choiyeoji/bremen-fpga-vision-orchestra/images/tb.png

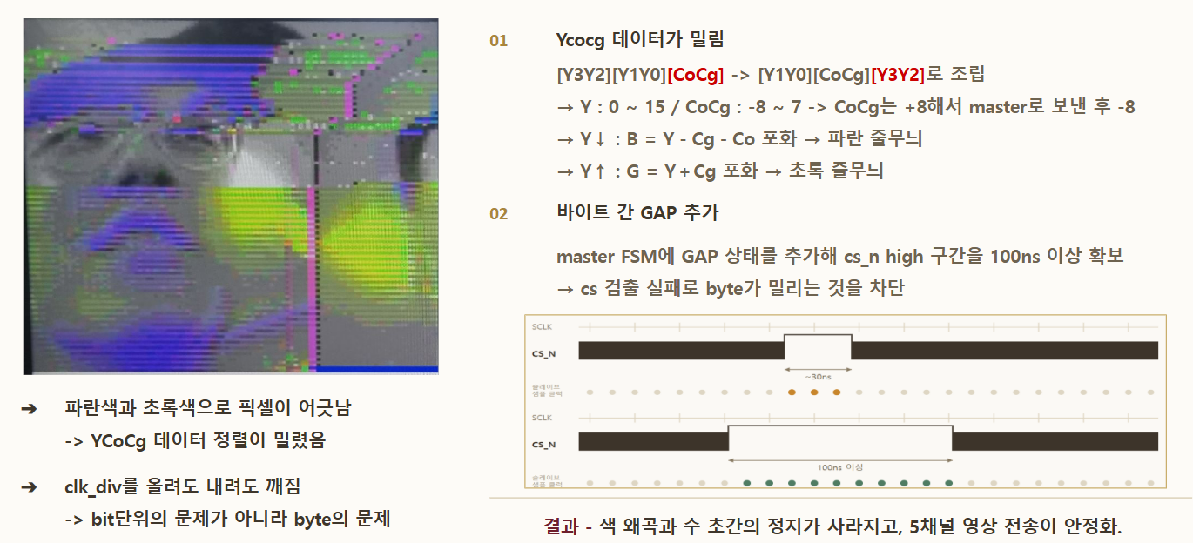
images/tb.png
