choiyeoji/bremen-fpga-vision-orchestra/images/uvm_bd.png

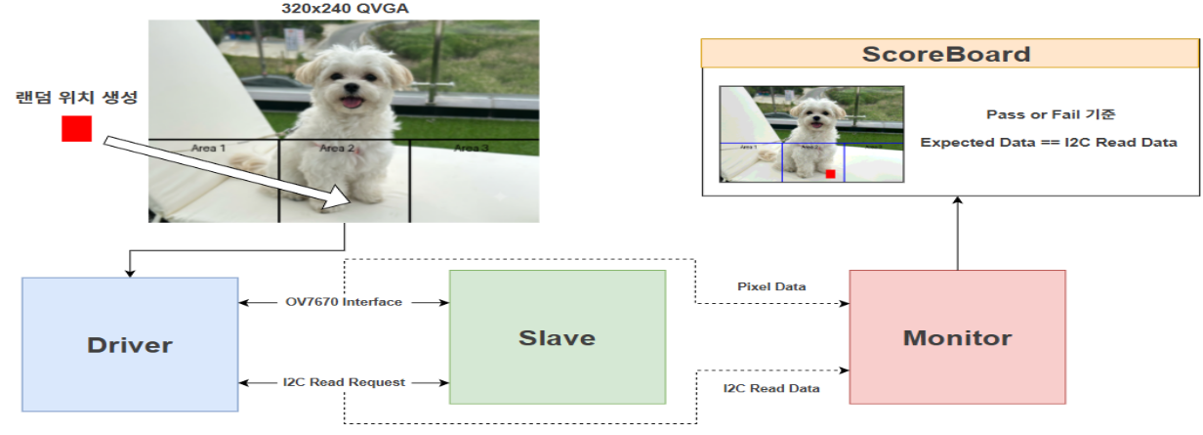
images/uvm_bd.png
