choiyeoji/bremen-fpga-vision-orchestra/images/uvm_report.png

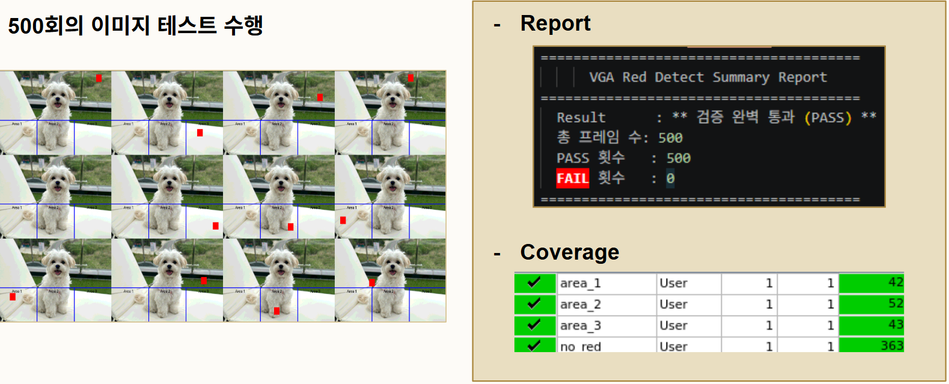
images/uvm_report.png
