choiyeoji/bremen-fpga-vision-orchestra/src/master/constraints/Basys-3-Master.xdc

## This file is a general .xdc for the Basys3 rev B board
## To use it in a project:
## - uncomment the lines corresponding to used pins
## - rename the used ports (in each line, after get_ports) according to the top level signal names in the project
# Clock signal
set_property -dict { PACKAGE_PIN W5   IOSTANDARD LVCMOS33 } [get_ports clk]
create_clock -add -name sys_clk_pin -period 10.00 -waveform {0 5} [get_ports clk]


# ## Switches
# set_property -dict { PACKAGE_PIN V17   IOSTANDARD LVCMOS33 } [get_ports {led[0]}]
# set_property -dict { PACKAGE_PIN V16   IOSTANDARD LVCMOS33 } [get_ports {led[1]}]
# set_property -dict { PACKAGE_PIN W16   IOSTANDARD LVCMOS33 } [get_ports {sw_mode[1]}]
# set_property -dict { PACKAGE_PIN W17   IOSTANDARD LVCMOS33 } [get_ports {sw_clr_red}]
# set_property -dict { PACKAGE_PIN W15   IOSTANDARD LVCMOS33 } [get_ports {sw_clr_green}]
# set_property -dict { PACKAGE_PIN V15   IOSTANDARD LVCMOS33 } [get_ports {sw_clr_blue}]
# set_property -dict { PACKAGE_PIN W14   IOSTANDARD LVCMOS33 } [get_ports {sw_green[2]}]
# set_property -dict { PACKAGE_PIN W13   IOSTANDARD LVCMOS33 } [get_ports {sw_green[3]}]
# set_property -dict { PACKAGE_PIN V2    IOSTANDARD LVCMOS33 } [get_ports {sw_blue[0]}]
# set_property -dict { PACKAGE_PIN T3    IOSTANDARD LVCMOS33 } [get_ports {sw_blue[1]}]
# set_property -dict { PACKAGE_PIN T2    IOSTANDARD LVCMOS33 } [get_ports {sw_blue[2]}]
# set_property -dict { PACKAGE_PIN R3    IOSTANDARD LVCMOS33 } [get_ports {sw_blue[3]}]
# set_property -dict { PACKAGE_PIN W2    IOSTANDARD LVCMOS33 } [get_ports {sw[12]}]
# set_property -dict { PACKAGE_PIN U1    IOSTANDARD LVCMOS33 } [get_ports {sw[13]}]
# set_property -dict { PACKAGE_PIN T1    IOSTANDARD LVCMOS33 } [get_ports {sw_mode}]
# set_property -dict { PACKAGE_PIN R2    IOSTANDARD LVCMOS33 } [get_ports {sw_mode[1]}]


## LEDs
set_property -dict { PACKAGE_PIN U16   IOSTANDARD LVCMOS33 } [get_ports {led[0]}]
set_property -dict { PACKAGE_PIN E19   IOSTANDARD LVCMOS33 } [get_ports {led[1]}]
set_property -dict { PACKAGE_PIN U19   IOSTANDARD LVCMOS33 } [get_ports {led[2]}]
set_property -dict { PACKAGE_PIN V19   IOSTANDARD LVCMOS33 } [get_ports {led[3]}]
set_property -dict { PACKAGE_PIN W18   IOSTANDARD LVCMOS33 } [get_ports {led[4]}]
set_property -dict { PACKAGE_PIN U15   IOSTANDARD LVCMOS33 } [get_ports {led[5]}]
set_property -dict { PACKAGE_PIN U14   IOSTANDARD LVCMOS33 } [get_ports {led[6]}]
set_property -dict { PACKAGE_PIN V14   IOSTANDARD LVCMOS33 } [get_ports {led[7]}]
#set_property -dict { PACKAGE_PIN V13   IOSTANDARD LVCMOS33 } [get_ports {led[8]}]
#set_property -dict { PACKAGE_PIN V3    IOSTANDARD LVCMOS33 } [get_ports {led[9]}]
#set_property -dict { PACKAGE_PIN W3    IOSTANDARD LVCMOS33 } [get_ports {led[10]}]
#set_property -dict { PACKAGE_PIN U3    IOSTANDARD LVCMOS33 } [get_ports {led[11]}]
#set_property -dict { PACKAGE_PIN P3    IOSTANDARD LVCMOS33 } [get_ports {led[12]}]
#set_property -dict { PACKAGE_PIN N3    IOSTANDARD LVCMOS33 } [get_ports {led[13]}]
#set_property -dict { PACKAGE_PIN P1    IOSTANDARD LVCMOS33 } [get_ports {led[14]}]
#set_property -dict { PACKAGE_PIN L1    IOSTANDARD LVCMOS33 } [get_ports {led[15]}]


##7 Segment Display
# set_property -dict { PACKAGE_PIN W7   IOSTANDARD LVCMOS33 } [get_ports {fnd_data[0]}]
# set_property -dict { PACKAGE_PIN W6   IOSTANDARD LVCMOS33 } [get_ports {fnd_data[1]}]
# set_property -dict { PACKAGE_PIN U8   IOSTANDARD LVCMOS33 } [get_ports {fnd_data[2]}]
# set_property -dict { PACKAGE_PIN V8   IOSTANDARD LVCMOS33 } [get_ports {fnd_data[3]}]
# set_property -dict { PACKAGE_PIN U5   IOSTANDARD LVCMOS33 } [get_ports {fnd_data[4]}]
# set_property -dict { PACKAGE_PIN V5   IOSTANDARD LVCMOS33 } [get_ports {fnd_data[5]}]
# set_property -dict { PACKAGE_PIN U7   IOSTANDARD LVCMOS33 } [get_ports {fnd_data[6]}]
# set_property -dict { PACKAGE_PIN V7   IOSTANDARD LVCMOS33 } [get_ports {fnd_data[7]}]

# set_property -dict { PACKAGE_PIN U2   IOSTANDARD LVCMOS33 } [get_ports {fnd_digit[0]}]
# set_property -dict { PACKAGE_PIN U4   IOSTANDARD LVCMOS33 } [get_ports {fnd_digit[1]}]
# set_property -dict { PACKAGE_PIN V4   IOSTANDARD LVCMOS33 } [get_ports {fnd_digit[2]}]
# set_property -dict { PACKAGE_PIN W4   IOSTANDARD LVCMOS33 } [get_ports {fnd_digit[3]}]


##Buttons
set_property -dict { PACKAGE_PIN U18   IOSTANDARD LVCMOS33 } [get_ports reset]
# set_property -dict { PACKAGE_PIN T18   IOSTANDARD LVCMOS33 } [get_ports OV_init_btn]
# set_property -dict { PACKAGE_PIN W19   IOSTANDARD LVCMOS33 } [get_ports btn_l]
# set_property -dict { PACKAGE_PIN T17   IOSTANDARD LVCMOS33 } [get_ports btn_r]
# set_property -dict { PACKAGE_PIN U17   IOSTANDARD LVCMOS33 } [get_ports btn_down]


##Pmod Header JA
set_property -dict { PACKAGE_PIN J1   IOSTANDARD LVCMOS33 } [get_ports {sclk}];#Sch name = JA1
# set_property -dict { PACKAGE_PIN L2   IOSTANDARD LVCMOS33 } [get_ports {miso[0]}];#Sch name = JA2
set_property -dict { PACKAGE_PIN J2   IOSTANDARD LVCMOS33 } [get_ports {mosi}];#Sch name = JA3
set_property -dict { PACKAGE_PIN G2   IOSTANDARD LVCMOS33 } [get_ports {cs_n[0]}];#Sch name = JA4
set_property -dict { PACKAGE_PIN H1   IOSTANDARD LVCMOS33 } [get_ports {cs_n[1]}];#Sch name = JA7
set_property -dict { PACKAGE_PIN K2   IOSTANDARD LVCMOS33 } [get_ports {cs_n[2]}];#Sch name = JA8
set_property -dict { PACKAGE_PIN H2   IOSTANDARD LVCMOS33 } [get_ports {cs_n[3]}];#Sch name = JA9
set_property -dict { PACKAGE_PIN G3   IOSTANDARD LVCMOS33 } [get_ports {cs_n[4]}];#Sch name = JA10

##Pmod Header JB
# set_property CLOCK_DEDICATED_ROUTE FALSE [get_nets pclk_IBUF]
set_property -dict { PACKAGE_PIN A14   IOSTANDARD LVCMOS33 } [get_ports {scl}];#Sch name = JB1
set_property -dict { PACKAGE_PIN A16   IOSTANDARD LVCMOS33 } [get_ports {vsync}];#Sch name = JB2
set_property -dict { PACKAGE_PIN B15   IOSTANDARD LVCMOS33 } [get_ports {sda}];#Sch name = JB3
# set_property -dict { PACKAGE_PIN B16   IOSTANDARD LVCMOS33 } [get_ports {sda}];#Sch name = JB4
# set_property -dict { PACKAGE_PIN A15   IOSTANDARD LVCMOS33 } [get_ports {href}];#Sch name = JB7
set_property -dict { PACKAGE_PIN A17   IOSTANDARD LVCMOS33 } [get_ports {href}];#Sch name = JB8
set_property -dict { PACKAGE_PIN C15   IOSTANDARD LVCMOS33 } [get_ports {xclk}];#Sch name = JB9
set_property -dict { PACKAGE_PIN C16   IOSTANDARD LVCMOS33 } [get_ports {pclk}];#Sch name = JB10


##Pmod Header JC
set_property -dict { PACKAGE_PIN K17   IOSTANDARD LVCMOS33 } [get_ports {pdata[7]}];#Sch name = JC1
set_property -dict { PACKAGE_PIN M18   IOSTANDARD LVCMOS33 } [get_ports {pdata[5]}];#Sch name = JC2
set_property -dict { PACKAGE_PIN N17   IOSTANDARD LVCMOS33 } [get_ports {pdata[3]}];#Sch name = JC3
set_property -dict { PACKAGE_PIN P18   IOSTANDARD LVCMOS33 } [get_ports {pdata[1]}];#Sch name = JC4
set_property -dict { PACKAGE_PIN L17   IOSTANDARD LVCMOS33 } [get_ports {pdata[6]}];#Sch name = JC7
set_property -dict { PACKAGE_PIN M19   IOSTANDARD LVCMOS33 } [get_ports {pdata[4]}];#Sch name = JC8
set_property -dict { PACKAGE_PIN P17   IOSTANDARD LVCMOS33 } [get_ports {pdata[2]}];#Sch name = JC9
set_property -dict { PACKAGE_PIN R18   IOSTANDARD LVCMOS33 } [get_ports {pdata[0]}];#Sch name = JC10


##Pmod Header JXADC
set_property -dict { PACKAGE_PIN J3   IOSTANDARD LVCMOS33 } [get_ports {miso[0]}];#Sch name = XA1_P
set_property -dict { PACKAGE_PIN L3   IOSTANDARD LVCMOS33 } [get_ports {miso[1]}];#Sch name = XA2_P
set_property -dict { PACKAGE_PIN M2   IOSTANDARD LVCMOS33 } [get_ports {miso[2]}];#Sch name = XA3_P
set_property -dict { PACKAGE_PIN N2   IOSTANDARD LVCMOS33 } [get_ports {miso[3]}];#Sch name = XA4_P
set_property -dict { PACKAGE_PIN K3   IOSTANDARD LVCMOS33 } [get_ports {miso[4]}];#Sch name = XA1_N
#set_property -dict { PACKAGE_PIN M3   IOSTANDARD LVCMOS33 } [get_ports {JXADC[5]}];#Sch name = XA2_N
set_property -dict { PACKAGE_PIN M1   IOSTANDARD LVCMOS33 } [get_ports {Mscale_scl}];#Sch name = XA3_N
set_property -dict { PACKAGE_PIN N1   IOSTANDARD LVCMOS33 } [get_ports {Mscale_sda}];#Sch name = XA4_N


##VGA Connector
set_property -dict { PACKAGE_PIN G19   IOSTANDARD LVCMOS33 } [get_ports {port_red[0]}]
set_property -dict { PACKAGE_PIN H19   IOSTANDARD LVCMOS33 } [get_ports {port_red[1]}]
set_property -dict { PACKAGE_PIN J19   IOSTANDARD LVCMOS33 } [get_ports {port_red[2]}]
set_property -dict { PACKAGE_PIN N19   IOSTANDARD LVCMOS33 } [get_ports {port_red[3]}]
set_property -dict { PACKAGE_PIN N18   IOSTANDARD LVCMOS33 } [get_ports {port_blue[0]}]
set_property -dict { PACKAGE_PIN L18   IOSTANDARD LVCMOS33 } [get_ports {port_blue[1]}]
set_property -dict { PACKAGE_PIN K18   IOSTANDARD LVCMOS33 } [get_ports {port_blue[2]}]
set_property -dict { PACKAGE_PIN J18   IOSTANDARD LVCMOS33 } [get_ports {port_blue[3]}]
set_property -dict { PACKAGE_PIN J17   IOSTANDARD LVCMOS33 } [get_ports {port_green[0]}]
set_property -dict { PACKAGE_PIN H17   IOSTANDARD LVCMOS33 } [get_ports {port_green[1]}]
set_property -dict { PACKAGE_PIN G17   IOSTANDARD LVCMOS33 } [get_ports {port_green[2]}]
set_property -dict { PACKAGE_PIN D17   IOSTANDARD LVCMOS33 } [get_ports {port_green[3]}]
set_property -dict { PACKAGE_PIN P19   IOSTANDARD LVCMOS33 } [get_ports h_sync]
set_property -dict { PACKAGE_PIN R19   IOSTANDARD LVCMOS33 } [get_ports v_sync]


##USB-RS232 Interface
set_property -dict { PACKAGE_PIN B18   IOSTANDARD LVCMOS33 } [get_ports uart_rx]
set_property -dict { PACKAGE_PIN A18   IOSTANDARD LVCMOS33 } [get_ports uart_tx]


##USB HID (PS/2)
#set_property -dict { PACKAGE_PIN C17   IOSTANDARD LVCMOS33   PULLUP true } [get_ports PS2Clk]
#set_property -dict { PACKAGE_PIN B17   IOSTANDARD LVCMOS33   PULLUP true } [get_ports PS2Data]


##Quad SPI Flash
##Note that CCLK_0 cannot be placed in 7 series devices. You can access it using the
##STARTUPE2 primitive.
#set_property -dict { PACKAGE_PIN D18   IOSTANDARD LVCMOS33 } [get_ports {QspiDB[0]}]
#set_property -dict { PACKAGE_PIN D19   IOSTANDARD LVCMOS33 } [get_ports {QspiDB[1]}]
#set_property -dict { PACKAGE_PIN G18   IOSTANDARD LVCMOS33 } [get_ports {QspiDB[2]}]
#set_property -dict { PACKAGE_PIN F18   IOSTANDARD LVCMOS33 } [get_ports {QspiDB[3]}]
#set_property -dict { PACKAGE_PIN K19   IOSTANDARD LVCMOS33 } [get_ports QspiCSn]


## Configuration options, can be used for all designs
set_property CONFIG_VOLTAGE 3.3 [current_design]
set_property CFGBVS VCCO [current_design]

## SPI configuration mode options for QSPI boot, can be used for all designs
# set_property BITSTREAM.GENERAL.COMPRESS TRUE [current_design]
# set_property BITSTREAM.CONFIG.CONFIGRATE 33 [current_design]
# set_property CONFIG_MODE SPIx4 [current_design]
