choiyeoji/bremen-fpga-vision-orchestra/(commit log)

2026-08-07 Revise team roles and enhance README content
    Updated team roles section and improved formatting of the README. Added new sections for frame synchronization, Master-Slave handshake, and YCoCg video compression.
2026-08-26 Refocus README on Ping-Pong frame buffer memory control role
